Casaluifred/vw-t4-smart-shower/LED-Edelstahltaster_h.webp

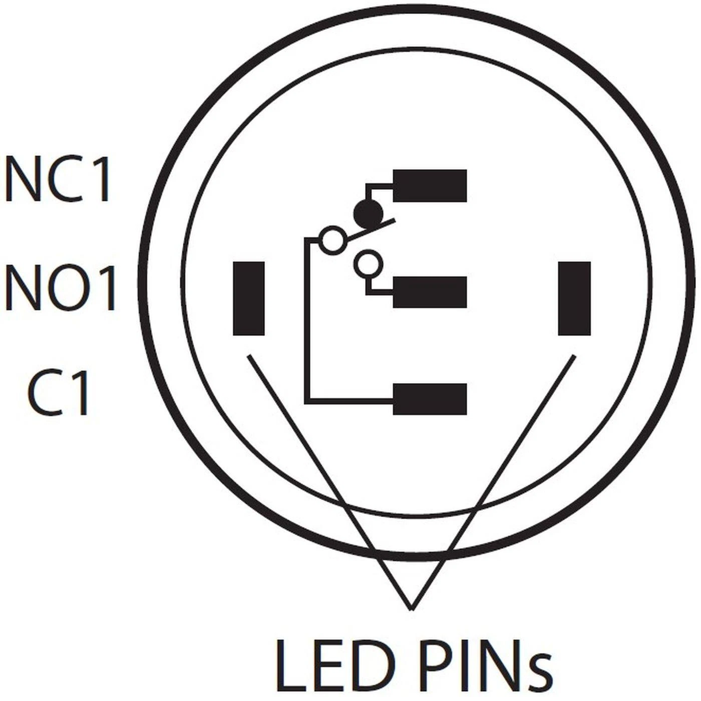
LED-Edelstahltaster_h.webp
