Casaluifred/vw-t4-smart-shower/LED-Edelstahltaster_v.webp

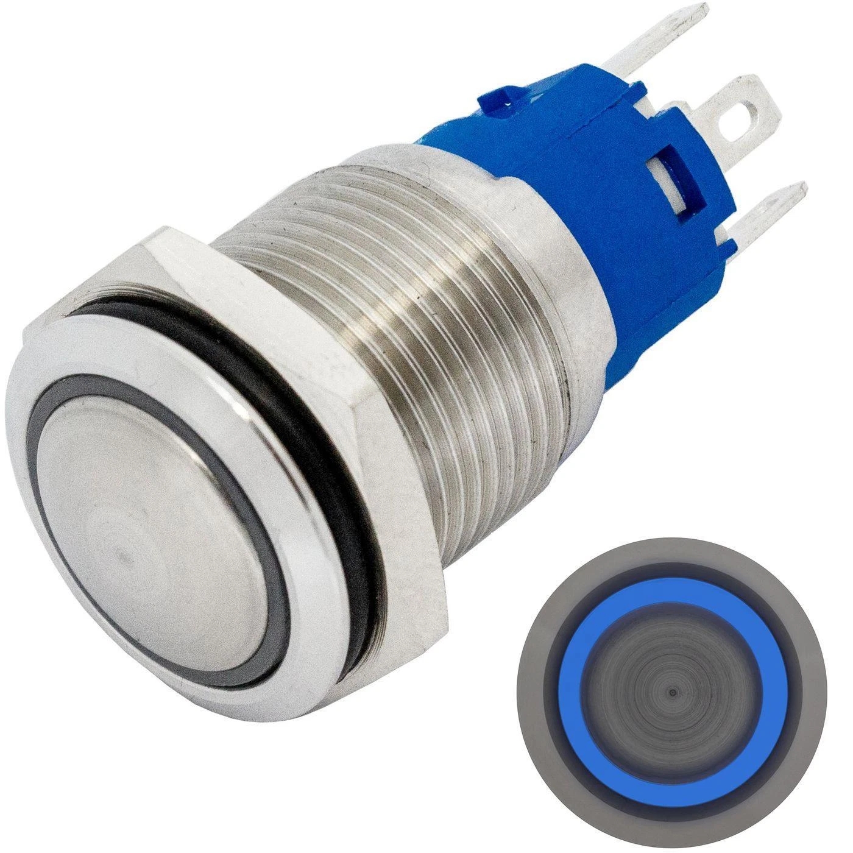
LED-Edelstahltaster_v.webp
