Casaluifred/vw-t4-smart-shower/Smartshower_eingebaut.jpg

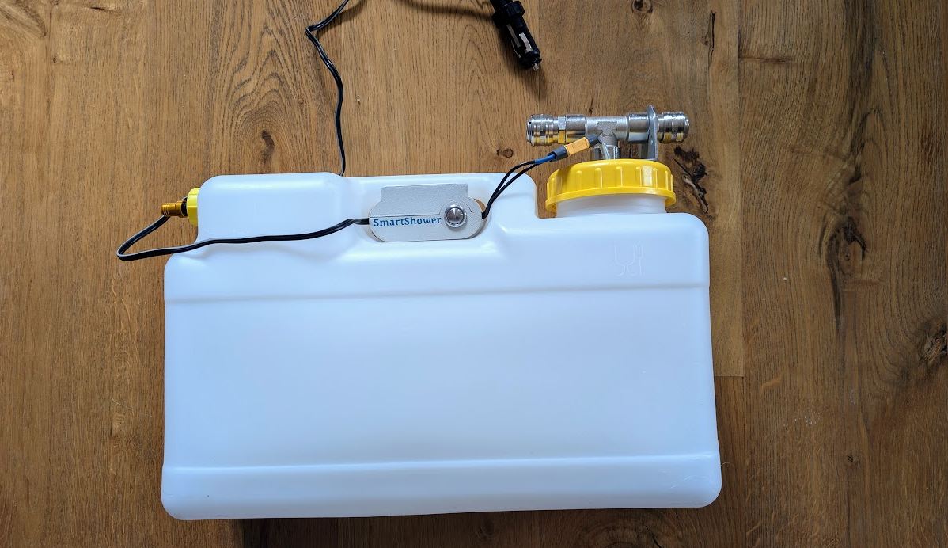
Smartshower_eingebaut.jpg
