Casaluifred/vw-t4-smart-shower/Smartshower_Elektronik_im_Gehaeuse.jpg

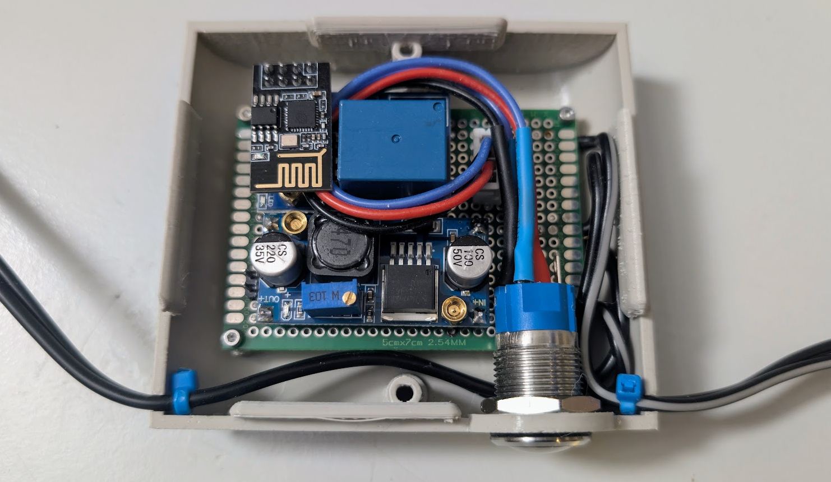
Smartshower_Elektronik_im_Gehaeuse.jpg
