Casaluifred/vw-t4-smart-shower/SmartShower_Gehaeuse.jpg

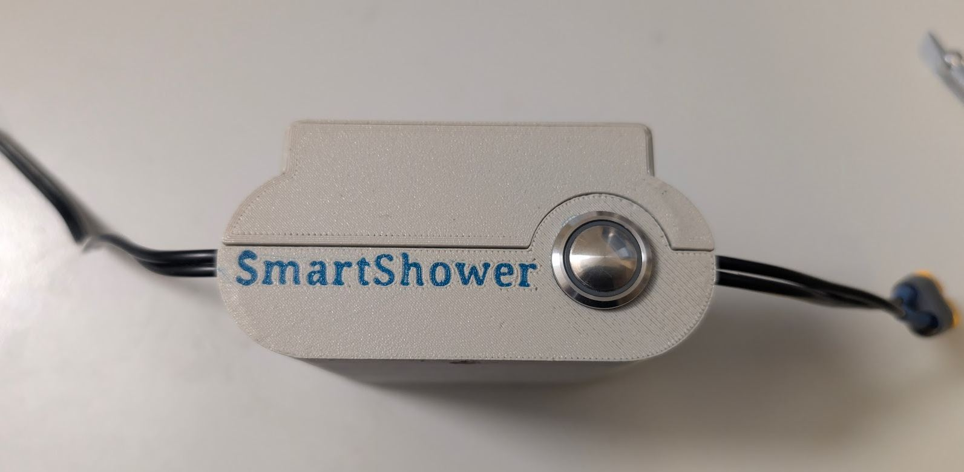
SmartShower_Gehaeuse.jpg
